ali-lahiani/esp-for-energy-mesurement-ade/screenshots/vs_serial_monitor.png

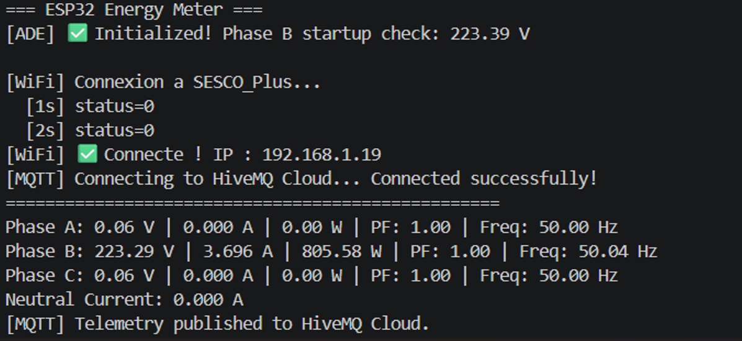
screenshots/vs_serial_monitor.png
