ali-lahiani/esp-for-energy-mesurement-ade/screenshots/mqtt.png

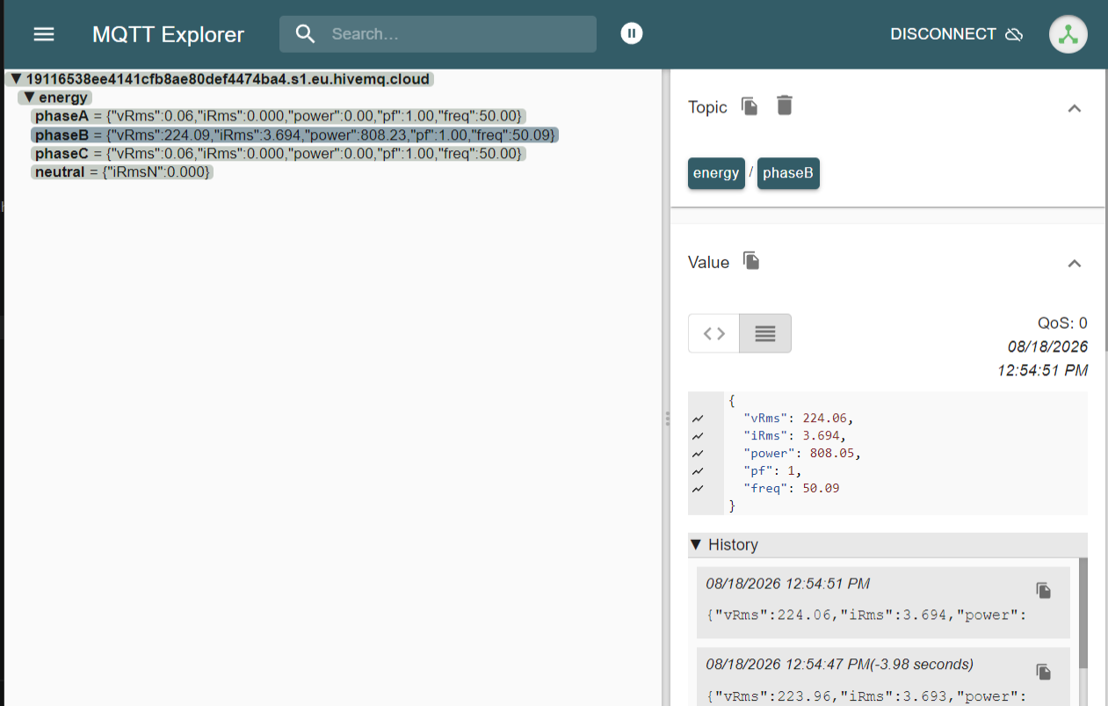
screenshots/mqtt.png
