ali-lahiani/esp-for-energy-mesurement-ade/screenshots/web.png

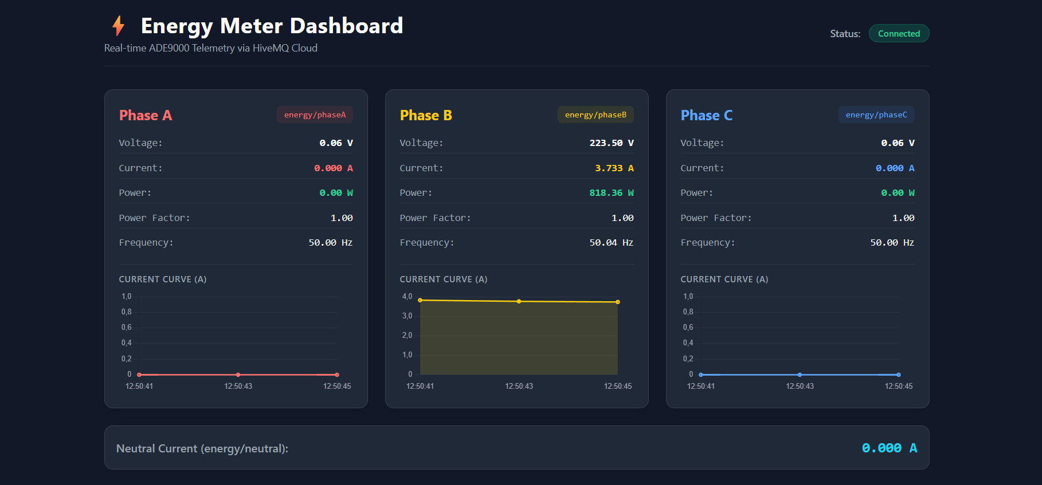
screenshots/web.png
