ali-lahiani/esp-for-energy-mesurement-ade/ADE9000_ESP32_DevKitC/ADE9000_ESP32_DevKitC_BOM.csv

Designator | Description | Qty | Manufacturer | Mfr Part # | Comments
R5, R6, R14, R15, R21, R22, R23, R24, R57, R59, R60, R62, R63, R64, R65, R66 | RES, 0, 0W1, 0603-SMT, ROHS | 16 | Yageo | RC0603JR-070RL
R43, R48, R52, R53, R54, R55, R56, R69 | RES, 10k, 0W1, 0603-SMT, ROHS | 8 | Yageo | RC0603JR-0710KL
R7, R8, R16, R17, R25, R26, R29, R32, R33, R35, R36, R40, R41, R42 | RES, 1k, 0W1, 0603-SMT, ROHS | 14 | Yageo | RC0603FR-071KL
R9, R12, R13, R18, R27, R28, R30, R31, R34, R37, R38, R39 | RES, 200k, 0W1, 2010-SMT, ROHS | 12 | Rohm Semiconductor | MCR50JZHF2003
R44, R45, R46, R47, R50 | RES, 3k, 0W1, 0603-SMT, ROHS | 5 | Yageo | RC0603FR-073KL
R1, R2, R3, R4, R10, R11, R19, R20 | RES, 5.1, 0W1, 0805-SMT, ROHS | 8 | TE Connectivity Passive Product | CPF0805B5R1E1
C19, C20, C24, C25, C29, C30, C31, C32, C33, C34, C35, C36 | CAP, 0.022uF, 50V, 5%, 0805-SMT, ROHS, C0G | 14 | TDK Corporation | CGA4J2C0G1H223J125AA
C1, C3, C4, C6, C8, C10, C12, C14, C44, C45, C46, C47, C49, C51, C53, C58, C60, C61, C63 | CAP, 0.1uF, 25V, 10%, 0603-SMT, ROHS, X7R | 19 | Murata Electronics North America | GRM188R71E104KA01D
C2, C9, C11, C13, C48, C50, C57, C59 | CAP, 10uF, 16V, 10%, 0805-SMT, ROHS, X7R | 8 | Samsung Electro-Mechanics America, Inc. | CL21B106KOQNNNE
C37, C38 | CAP, 18pF, 50V, 1%, 0402-SMT, ROHS, C0G | 2 | Murata Electronics North America | GRM1555C1H180FA01D
C39, C56 | CAP, 1uF, 50V, 10%, 0603-SMT, ROHS, X7R | 2 | Taiyo Yuden | UMK107AB7105KA-T
C62 | CAP, 22uF, 25V, 20%, 0805-SMT, ROHS, X5R | 1 | Murata Electronics North America | GRM21BR61E226ME44L
C5, C7, C40 | CAP, 4.7uF, 25V, 10%, 0805-SMT, ROHS, X5R | 3 | Murata Electronics North America | GRM21BR61E475KA12L
C41, C42, C43 | CAP, 4.7uF, 25V, 10%,0603-SMT, ROHS, X5R | 3 | TDK Corporation | C1608X5R1E475M080AC
C52, C54, C55 | CAP, 51pF, 50V, 5%, 0402-SMT, ROHS, C0G | 3 | Samsung Electro-Mechanics America, Inc. | CL05C510JB5NNNC
L1, L2, L3, L4 | FERRITE BEAD, 1500 Ohm, 0805-SMT | 4 | Murata Electronics North America | BLM21BD152SN1D
J8 | VOLTAGE_SOCKET_4MM_BLACK | 1 | STAUBLI/Multi Contact | 23.3200-21
J5, J6, J7 | VOLTAGE_SOCKET_4MM_RED | 3 | STAUBLI/Multi Contact | 23.3200-22
IC1 | IC, EEPROM, 32KBIT, 400KHZ, 8SOIC-3.9mm | 1 | Microchip Technology | 24LC32AT-I/SN
LED1, LED2, LED3, LED6 | LED, 1.8V, 2mA, RED, 0603 | 4 | Kingbright | APT1608LSECK/J3-PRV
LED5 | LED, 2.65V, 2mA, GREEN, 0603 | 1 | Kingbright | APT1608LZGCK
D1, D2 | DIODE, SCHOTTKY, 30V, 100mA, SOD323 | 2 | Diodes Incorporated | BAT54WS-7-F
Q8 | CRYSTAL, 24.576MHZ ,12PF, 4-SMD | 1 | ECS Inc. | ECS-245.7-12-33Q-JES-TR
Q1, Q2, Q3, Q4, Q5, Q6, Q7, Q9 | DIODE, Dual Series Connection, 100V, SOT-23-3 | 8 | Fairchild/ON Semiconductor | MMBD4148SE
J9 | CONN, Receptable, USB MICRO AB, SMD | 1 | Hirose Electric Co Ltd | ZX62-AB-5PA(31)
SL1, SL2, SL3, SL4 | TERMINAL BLOCK, 2 Position, 5mm Pitch, Through Hole | 4 | On Shore Technology Inc. | ED350/2
U1 | IC, ADE9000, Poly Phase Metering AFE, 40-LFCSP | 1 | Analog Devices | ADE9000ACPZ
U4 | IC, ADP122, Linear Regulator,3.3V, 5-TSOT | 1 | Analog Devices | ADP122AUJZ-3.3-R7
U5 | IC, ADUM4151, SPI Isolator, 17MHz, 2/1 Data, 20-SOIC | 1 | Analog Devices | ADUM4151BRIZ-RL
U2 | IC, ADUM6404, ISO Power, 0/4 Data, 16-SOIC | 1 | Analog Devices | ADUM6404ARIZ
S2 | SWITCH, TACTILE SPST-NO, Surface Mount, 6mm x 6mm, 4 Lead | 1 | C&K | PTS645SM43SMTR92 LFS
U3, U6 | IC, SN74LV4T125,Level Translator, Non Inverting, 14-TSSOP | 2 | Texas Instruments | SN74LV4T125PWR
TP5, TP6, TP7, TP8, TP9, TP10, TP15, TP16, TP17, TP18, TP19, TP20, TP21, TP22, TP31, TP32 | TEST POINT, 0.063", White | 16 | Keystone Electronics | 5007
J10 | Connector, Receptable, 3x2, 0.1" Pitch | 1 | Sullins Connector Solutions | PPTC032LFBN-RC | J10 is mounted on bottom layer. Pin orientation does not matter
J4 | Connector, Receptable, 6x1, 0.1" Pitch | 1 | Samtec Inc. | SSQ-106-03-T-S
J2, J3 | Connector, Receptable, 8x1, 0.1" Pitch | 2 | Samtec Inc. | SSQ-108-03-T-S
J1 | Connector, Receptable, 10x1, 0.1" Pitch | 1 | Samtec Inc. | SSQ-110-03-F-S
TP1, TP2, TP3, TP4, TP11, TP12, TP13, TP14, TP23, TP24, TP25, TP26, TP27, TP28, TP29, TP30 | Test Pad | 16
H1, H2, H3, H4, H5, H6 | Mount Hole | 6
R49, R51, R58, R61, R67, R68 | DNI | 6
C15, C16, C17, C18, C21, C22, C26, C28 | DNI | 8
SV1, SV2 | DNI | 2 | Sullins Connector Solutions | PPTC151LFBN-RC
