ali-lahiani/esp-for-energy-mesurement-ade/final module esp/ADE9000 Shield.brd

## EAGLE design final module esp/ADE9000 Shield.brd (2026-08-11)

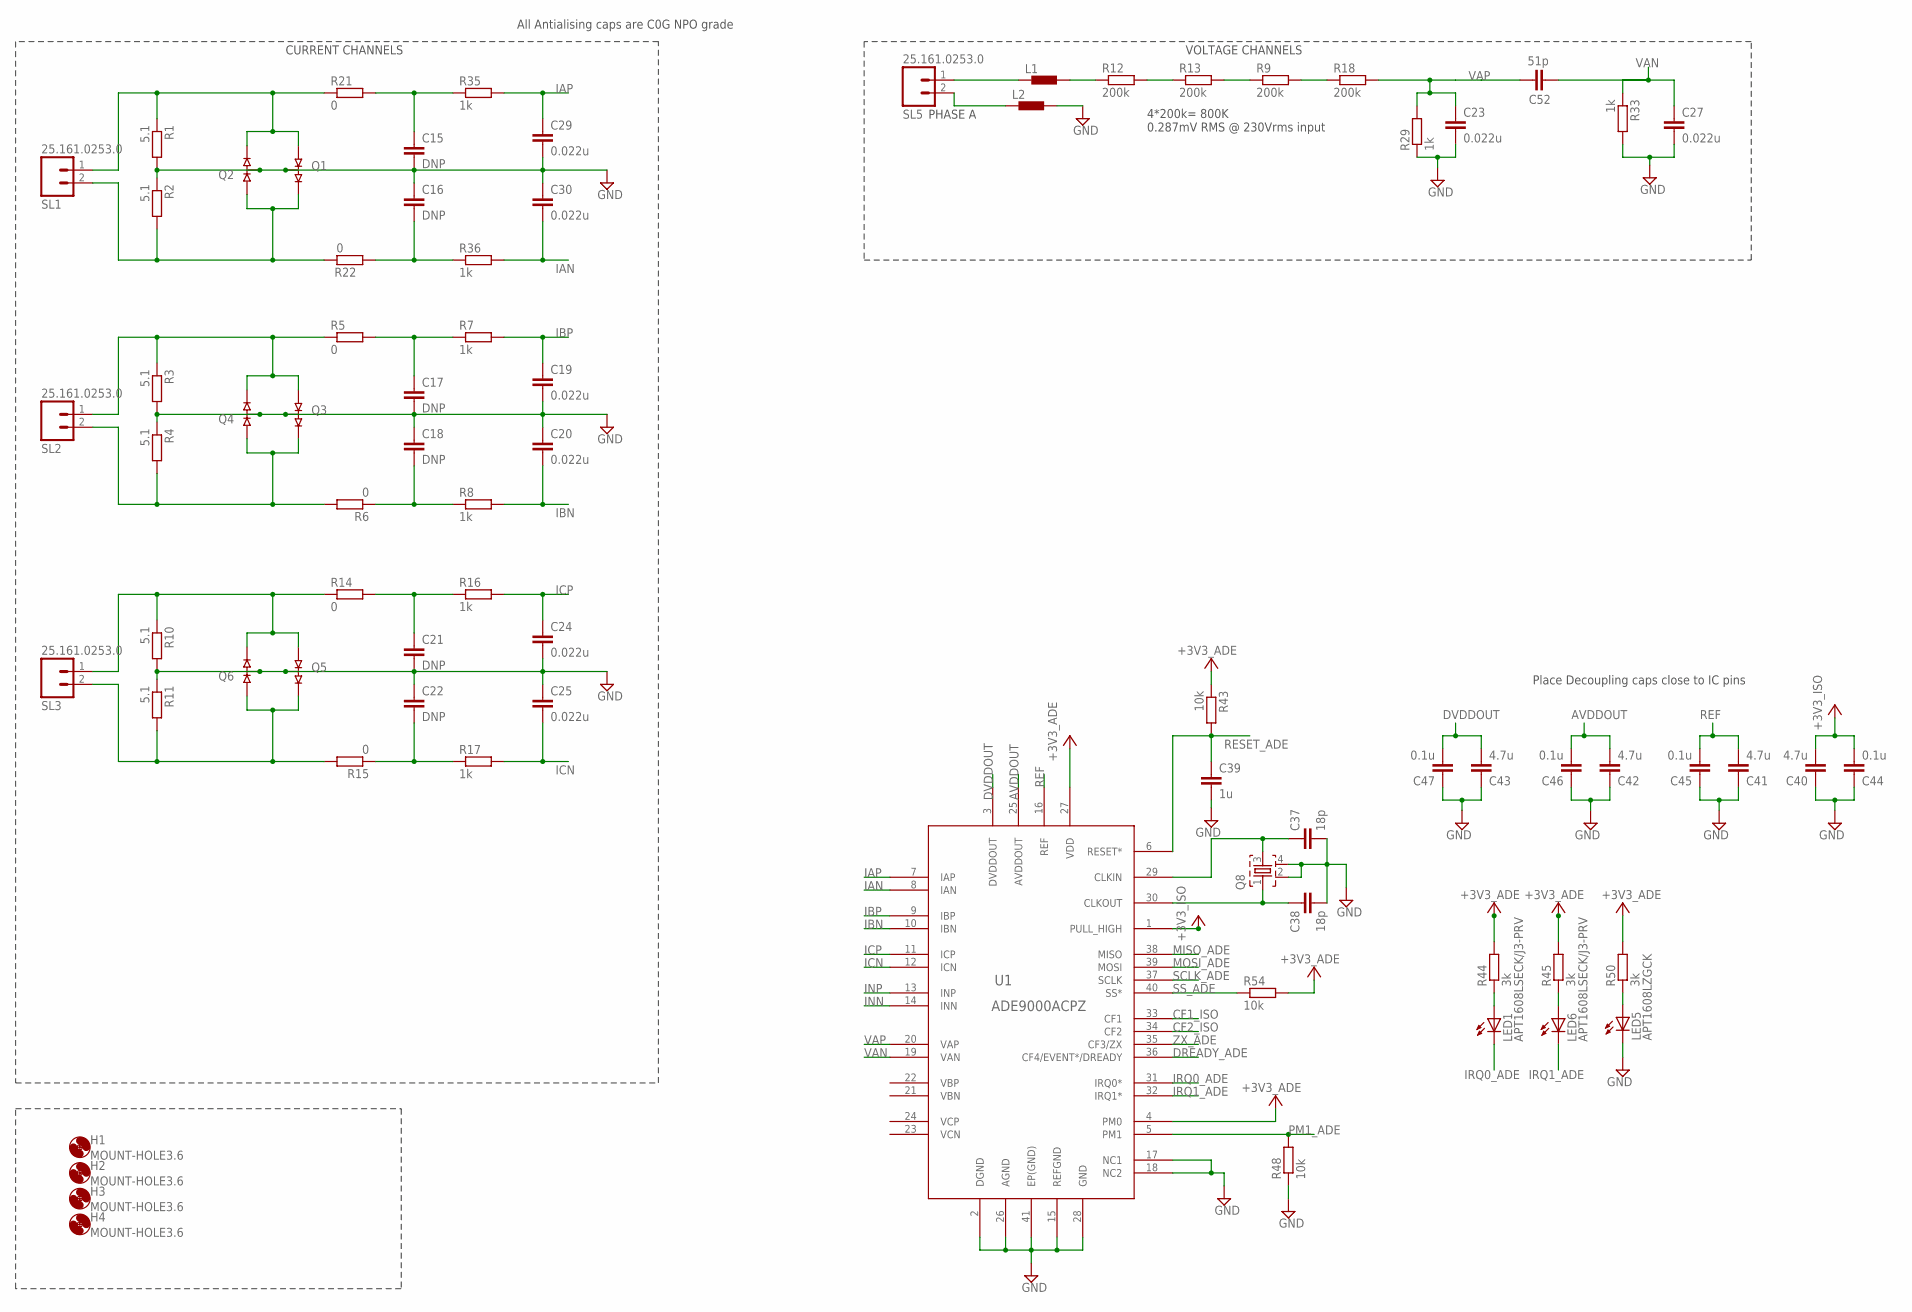
[picture p4: schematic ADE9000 Shield.sch, sheet 1]

Parts:
C15, C16, C17, C18, C21, C22: DNP; C0805
C19, C20, C23, C24, C25, C27, C29, C30: 0.022u; C0805
C37, C38: 18p; C0402
C39: 1u; C0603
C40: 4.7u; C0805
C41, C42, C43: 4.7u; C0603
C44, C45, C46, C47: 0.1u; C0603
C52: 51p; C0402
H1, H2, H3, H4: MOUNT-HOLE3.6; 3,6
L1, L2: 1500; M0805; DIGIKEY 490-1048-1-ND
LED1, LED6: APT1608LSECK/J3-PRV; SML0603; PARTNO APT1608LSECK/J3-PRV
LED5: APT1608LZGCK; SML0603; PARTNO APT1608LZGCK
Q1, Q2, Q3, Q4, Q5, Q6: MMBD4148SE; SOT23-3; DIGIKEY MMBD4148SECT-ND
Q8: ECS-245.7-12-33Q-JES-TR; SMD_4PIN_3.2X2.1; DIGIKEY XC2178CT-ND
R1: 5.1; R0805; MFR_PART_NO_# CPF0805B5R1E1
R2, R3, R4, R10, R11: 5.1; R0805
R5, R6, R14, R15, R21, R22: 0; R0603
R7, R8, R16, R17, R29, R33, R35, R36: 1k; R0603
R9, R12, R13, R18: 200k; R2010
R43, R48, R54: 10k; R0603
R44, R45, R50: 3k; R0603
SL1, SL2, SL3, SL5: 25.161.0253.0; 02P
U1: ADE9000ACPZ; CP_40_7; DIGIKEY ADE9000ACPZ-RLCT-ND

Connections:
+3V3: C40.2, C44.2, R43.1, R44.2, R45.2, R50.2, R54.2, U1.1 (PULL_HIGH), U1.4 (PM0), U1.27 (VDD); also elsewhere on the board
AVDDOUT: C42.2, C46.2, U1.25 (AVDDOUT)
CF1_ISO: U1.33 (CF1)
CF2_ISO: U1.34 (CF2)
DREADY_ADE: U1.36 (CF4/EVENT*/DREADY); also elsewhere on the board
DVDDOUT: C43.2, C47.2, U1.3 (DVDDOUT)
GND: C15.2, C16.1, C17.2, C18.1, C19.2, C20.1, C21.2, C22.1, C23.2, C24.2, C25.1, C27.2, C29.2, C30.1, C37.2, C38.2, C39.2, C40.1, C41.1, C42.1, C43.1, C44.1, C45.1, C46.1, C47.1, L2.2, LED5.C, Q1.3, Q2.3, Q3.3, Q4.3, Q5.3, Q6.3, Q8.2, Q8.4, R1.2, R2.1, R3.2, R4.1, R10.2, R11.1, R29.1, R33.2, R48.1, U1.2 (DGND), U1.15 (REFGND), U1.17 (NC1), U1.18 (NC2), U1.26 (AGND), U1.28 (GND), U1.41 (EP(GND)); also elsewhere on the board
IAN: C30.2, R36.2, U1.8 (IAN)
IAP: C29.1, R35.2, U1.7 (IAP)
IBN: C20.2, R8.2, U1.10 (IBN)
IBP: C19.1, R7.2, U1.9 (IBP)
ICN: C25.2, R17.2, U1.12 (ICN)
ICP: C24.1, R16.2, U1.11 (ICP)
INN: U1.14 (INN)
INP: U1.13 (INP)
IRQ0_ADE: LED1.C, U1.31 (IRQ0*); also elsewhere on the board
IRQ1_ADE: LED6.C, U1.32 (IRQ1*); also elsewhere on the board
MISO_ADE: U1.38 (MISO); also elsewhere on the board
MOSI_ADE: U1.39 (MOSI); also elsewhere on the board
unnamed: C37.1, Q8.3, U1.29 (CLKIN)
unnamed: C38.1, Q8.1, U1.30 (CLKOUT)
unnamed: Q3.1, Q4.2, R3.1, R5.1, SL2.1
unnamed: Q3.2, Q4.1, R4.2, R6.2, SL2.2
unnamed: C18.2, R6.1, R8.1
unnamed: Q1.1, Q2.2, R1.1, R21.1, SL1.1
unnamed: C17.1, R5.2, R7.1
unnamed: Q5.1, Q6.2, R10.1, R14.1, SL3.1
unnamed: Q5.2, Q6.1, R11.2, R15.2, SL3.2
unnamed: C16.2, R22.1, R36.1
unnamed: L2.1, SL5.2
unnamed: C22.2, R15.1, R17.1
unnamed: C21.1, R14.2, R16.1
unnamed: LED1.A, R44.1
unnamed: LED6.A, R45.1
unnamed: L1.2, R12.1
unnamed: R12.2, R13.1
unnamed: R9.1, R13.2
unnamed: R9.2, R18.1
unnamed: Q1.2, Q2.1, R2.2, R22.2, SL1.2
unnamed: C15.1, R21.2, R35.1
unnamed: LED5.A, R50.1
unnamed: L1.1, SL5.1
PM1_ADE: R48.2, U1.5 (PM1); also elsewhere on the board
REF: C41.2, C45.2, U1.16 (REF)
RESET_ADE: C39.1, R43.2, U1.6 (RESET*); also elsewhere on the board
SCLK_ADE: U1.37 (SCLK); also elsewhere on the board
SS_ADE: R54.1, U1.40 (SS*); also elsewhere on the board
VAN: C27.1, C52.1, R33.1, U1.19 (VAN)
VAP: C23.1, C52.2, R18.2, R29.2, U1.20 (VAP)
ZX_ADE: U1.35 (CF3/ZX); also elsewhere on the board

Notes on the sheet:
Place Decoupling caps close to IC pins
VOLTAGE CHANNELS
CURRENT CHANNELS
4*200k= 800K 0.287mV RMS @ 230Vrms input
All Antialising caps are C0G NPO grade
PHASE A

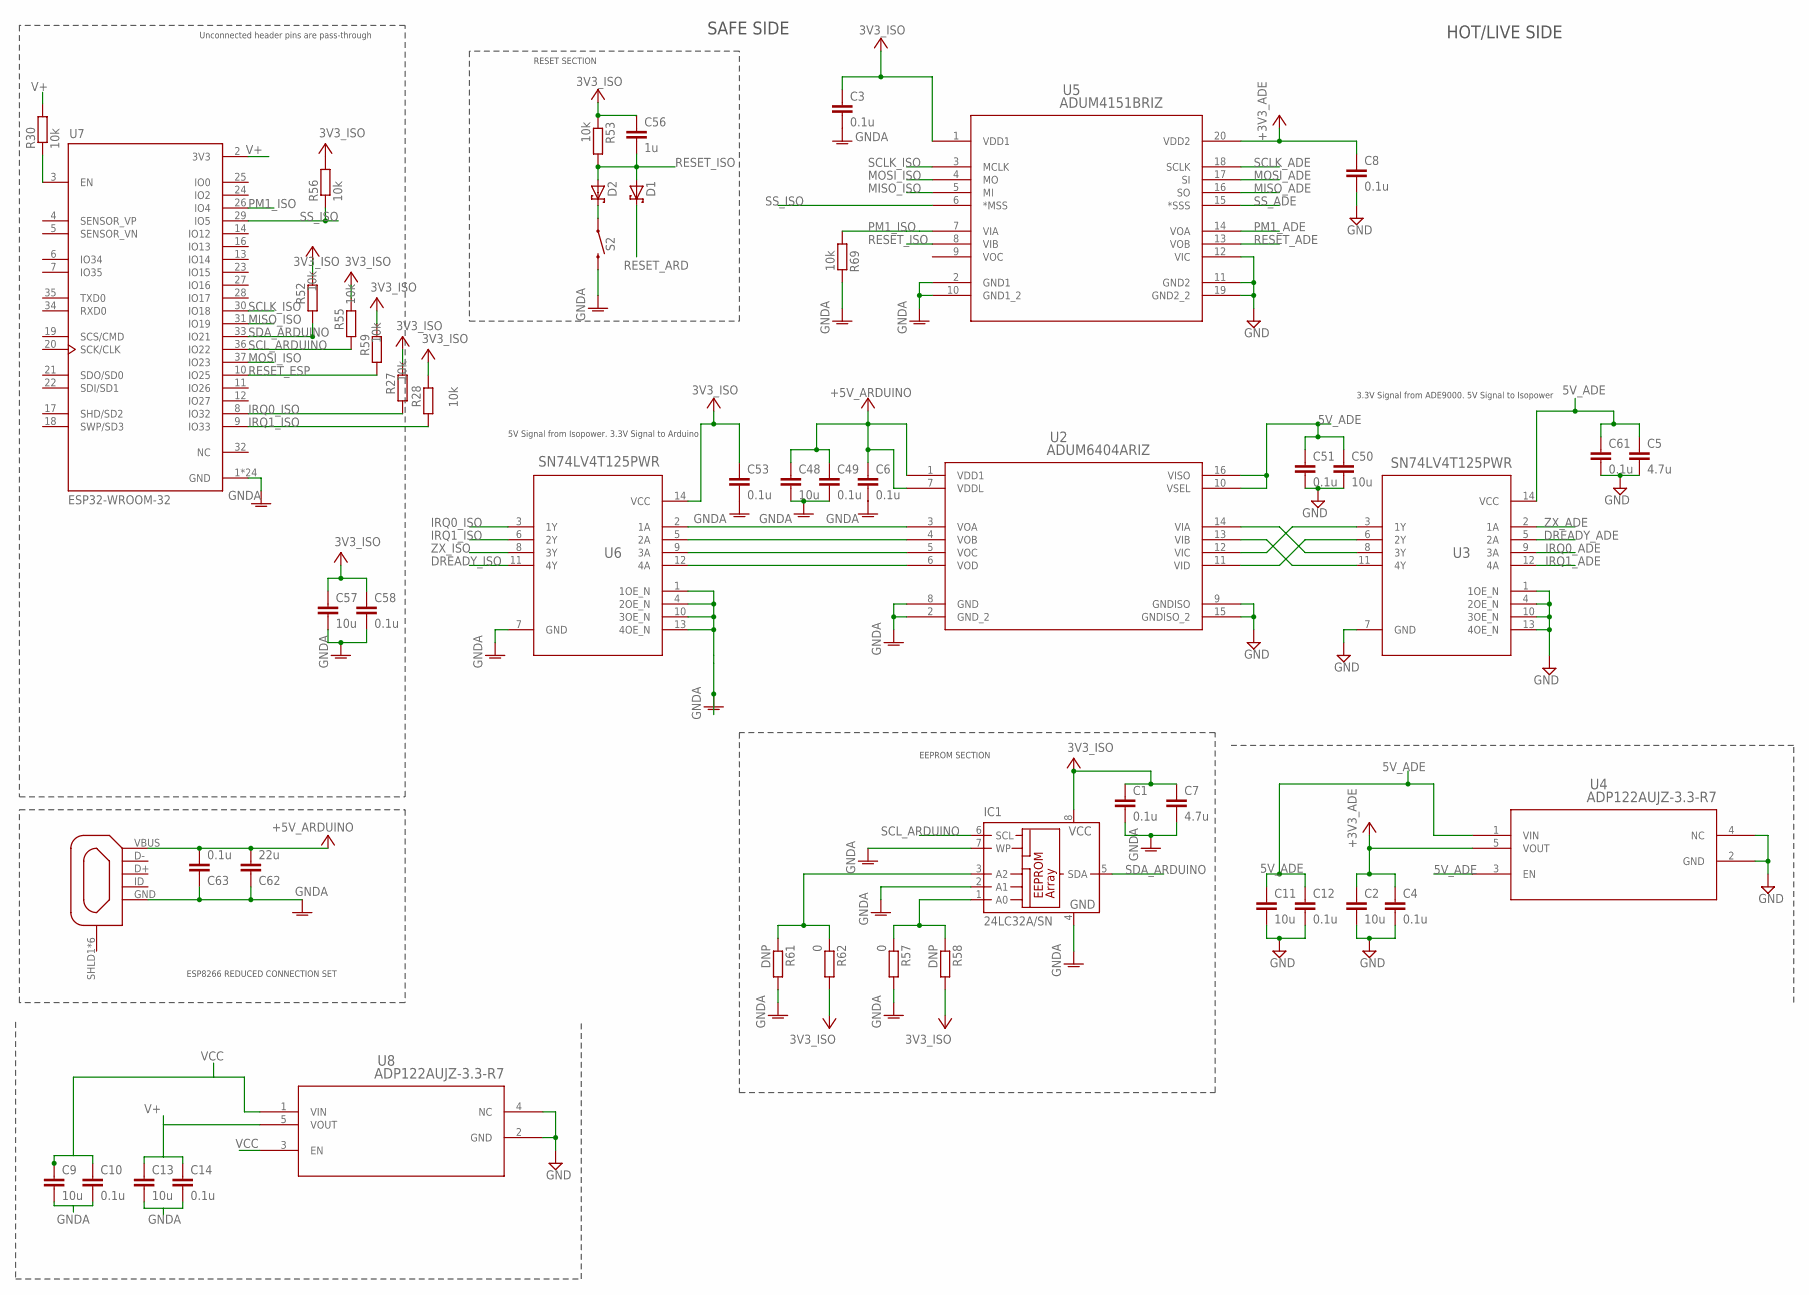
[picture p5: schematic ADE9000 Shield.sch, sheet 2]

Parts:
C1, C3, C4, C6, C8, C10, C12, C14, C49, C51, C53, C58, C61, C63: 0.1u; C0603
C2, C9, C11, C13, C48, C50, C57: 10u; C0805
C5, C7: 4.7u; C0805
C56: 1u; C0603
C62: 22u; C0805
D1, D2: BAT54WS; SOD323_ST
IC1: 24LC32A/SN; SO-08
J9: ZX62-AB-5PA(31); USB-MICRO-10103594; MFRPART# ZX62-AB-5PA(31)
R27, R28, R30, R52, R53, R55, R56, R59, R69: 10k; R0603
R57, R62: 0; R0603
R58, R61: DNP; R0603
S2: PTS645SM43SMTR92; TACTILE_SWITCH_SMD_6.2MM_TALL
U2: ADUM6404ARIZ; RI_16_1
U3, U6: SN74LV4T125PWR; PW0014A_N
U4, U8: ADP122AUJZ-3.3-R7; UJ_5
U5: ADUM4151BRIZ; RI_20_1
U7: ESP32-WROOM-32; MODULE_ESP32-WROOM-32

Connections:
5V_ADE: C5.1, C11.1, C12.1, C50.1, C51.1, C61.1, U2.10 (VSEL), U2.16 (VISO), U3.14 (VCC), U4.1 (VIN), U4.3 (EN)
+3V3: C2.1, C4.1, C8.1, U4.5 (VOUT), U5.20 (VDD2); also elsewhere on the board
DREADY_ADE: U3.5 (2A); also elsewhere on the board
DREADY_ISO: U6.11 (4Y)
GND: C2.2, C4.2, C5.2, C8.2, C11.2, C12.2, C50.2, C51.2, C61.2, U2.9 (GNDISO), U2.15 (GNDISO_2), U3.1 (1OE_N), U3.4 (2OE_N), U3.7 (GND), U3.10 (3OE_N), U3.13 (4OE_N), U4.2 (GND), U4.4 (NC), U5.11 (GND2), U5.12 (VIC), U5.19 (GND2_2), U8.2 (GND), U8.4 (NC); also elsewhere on the board
GNDA: C1.2, C3.2, C6.2, C7.2, C9.2, C10.2, C13.2, C14.2, C48.2, C49.2, C53.2, C57.2, C58.2, C62.1, C63.1, IC1.2 (A1), IC1.4 (GND), IC1.7 (WP), J9.GND, R57.2, R61.2, R69.2, S2.B2 (2), U2.2 (GND_2), U2.8 (GND), U5.2 (GND1), U5.10 (GND1_2), U6.1 (1OE_N), U6.4 (2OE_N), U6.7 (GND), U6.10 (3OE_N), U6.13 (4OE_N), U7.1 (GND), U7.15 (GND), U7.38 (GND), U7.39_1 (GND), U7.39_2 (GND), U7.39_3 (GND), U7.39_4 (GND), U7.39_5 (GND), U7.39_6 (GND), U7.39_7 (GND), U7.39_8 (GND), U7.39_9 (GND), U7.39_10 (GND), U7.39_11 (GND), U7.39_12 (GND), U7.39_13 (GND), U7.39_14 (GND), U7.39_15 (GND), U7.39_16 (GND), U7.39_17 (GND), U7.39_18 (GND), U7.39_19 (GND), U7.39_20 (GND), U7.39_21 (GND)
IRQ0_ADE: U3.9 (3A); also elsewhere on the board
IRQ0_ISO: R27.1, U6.3 (1Y), U7.8 (IO32)
IRQ1_ADE: U3.12 (4A); also elsewhere on the board
IRQ1_ISO: R28.1, U6.6 (2Y), U7.9 (IO33)
MISO_ADE: U5.16 (SO); also elsewhere on the board
MISO_ISO: U5.5 (MI), U7.31 (IO19)
MOSI_ADE: U5.17 (SI); also elsewhere on the board
MOSI_ISO: U5.4 (MO), U7.37 (IO23)
unnamed: IC1.3 (A2), R61.1, R62.1
unnamed: R30.1, U7.3 (EN)
unnamed: U2.14 (VIA), U3.8 (3Y)
unnamed: U2.13 (VIB), U3.11 (4Y)
unnamed: D2.C, S2.A2 (1)
unnamed: U2.12 (VIC), U3.3 (1Y)
unnamed: U2.11 (VID), U3.6 (2Y)
unnamed: U2.3 (VOA), U6.2 (1A)
unnamed: U2.4 (VOB), U6.5 (2A)
unnamed: U2.5 (VOC), U6.9 (3A)
unnamed: U2.6 (VOD), U6.12 (4A)
unnamed: IC1.1 (A0), R57.1, R58.1
PM1_ADE: U5.14 (VOA); also elsewhere on the board
PM1_ISO: R69.1, U5.7 (VIA), U7.26 (IO4)
RESET_ADE: U5.13 (VOB); also elsewhere on the board
RESET_ARD: D1.C
RESET_ESP: R59.1, U7.10 (IO25)
RESET_ISO: C56.2, D1.A, D2.A, R53.2, U5.8 (VIB)
SCLK_ADE: U5.18 (SCLK); also elsewhere on the board
SCLK_ISO: U5.3 (MCLK), U7.30 (IO18)
SCL_ARDUINO: IC1.6 (SCL), R55.1, U7.36 (IO22)
SDA_ARDUINO: IC1.5 (SDA), R52.1, U7.33 (IO21)
SS_ADE: U5.15 (*SSS); also elsewhere on the board
SS_ISO: R56.1, U5.6 (*MSS), U7.29 (IO5)
V+: C1.1, C3.1, C7.1, C13.1, C14.1, C53.1, C56.1, C57.1, C58.1, IC1.8 (VCC), R27.2, R28.2, R30.2, R52.2, R53.1, R55.2, R56.2, R58.2, R59.2, R62.2, U5.1 (VDD1), U6.14 (VCC), U7.2 (3V3), U8.5 (VOUT)
VCC: C6.1, C9.1, C10.1, C48.1, C49.1, C62.2, C63.2, J9.VBUS, U2.1 (VDD1), U2.7 (VDDL), U8.1 (VIN), U8.3 (EN)
ZX_ADE: U3.2 (1A); also elsewhere on the board
ZX_ISO: U6.8 (3Y)

Notes on the sheet:
5V Signal from Isopower. 3.3V Signal to Arduino
Unconnected header pins are pass-through
HOT/LIVE SIDE
SAFE SIDE
3.3V Signal from ADE9000. 5V Signal to Isopower
EEPROM SECTION
RESET SECTION
ESP8266 REDUCED CONNECTION SET

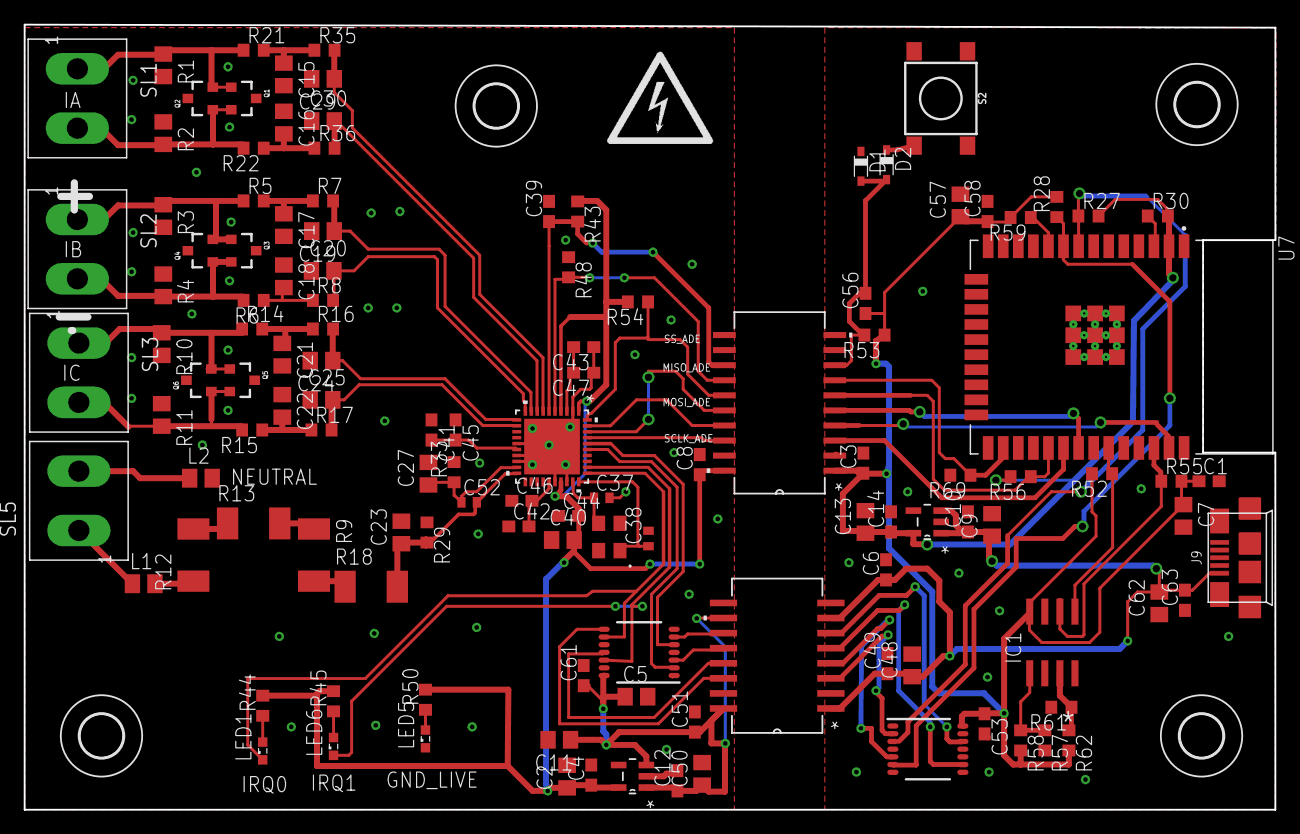
[picture p6: board ADE9000 Shield.brd from above]

Board: 2 copper layers, 105.4 x 66.2 mm, 128 parts (0 on the bottom side), 73 nets.

Other parts of the board:
DRILEGEND: DRILEGEND
